McHauge/Smoke-Stopper/README.md

FOSSA Status (https://app.fossa.io/projects/git%2Bgithub.com%2FMcHauge%2FSmoke-Stopper?ref=badge_shield)

---- Smoke Stopper ----

Designed to stop the magic smoke from escaping when testing drones.

---- Development ----

Primary editor: McHauge

Current version: V8.1 has been produced and testet, now looking to fix some of the isues in V8.1 and aply that to V10

Beta Version:	
V10 - Comes with the aim to solve the problem of the mosfet used as the switch, 
failing and shorting the rails, effectively bypasing the hole system.
- Added more portection circuit
- Changed a few values of components

---- Earlier Versions ----

V9 - Layout more production friendly and in a smaller form factor.

V8.1 - Swaps some components with some of a cheaper type resulting in
about 2,5 EUR cheaper in just raw component cost, also gets a more responsive and smaller 
push button for reseting, together with a more solid on/off slider.

version V7.0 and V7.1 - With better polarity protection than V6.0, 
this meaning it will protect if the power into the input is wrong it will protect, 
but if the polarity error is after this unit then this will not protect before it trips.

version V6.0 - Tested and working, first stable version that would allow motor idling.

version V5.0 - First version to work but would not allow the drone to start up.

version V1.0-V4.0 - doesn't work as intended, does nothing, burns, or wont turn of again.

---- History ----

2018-Jul-09 - V10 In the works has a few changes in the output circuit

2017-Dec-20 - V9 Designed and made ready for production 

2017-Dec-20 - V8.1 is the 8.0 with correct solder-pads for the swapped components

2017-Dec-20 - V8 Tested with cheaper components

2017-OCT-11 - V7 has been tested with success, this version has better polarity protection.

2017-OCT-9 - All files a now up on GitHub.

2017-jan-xx - project began

## License
FOSSA Status (https://app.fossa.io/projects/git%2Bgithub.com%2FMcHauge%2FSmoke-Stopper?ref=badge_large)
