McHauge/Smoke-Stopper/V9 - Beta Production/BOM_V9.xlsx

Bill of Materials for 2-6s 3A Smoke Stopper v9.sch on 13-03-2018 10:03:37
Name | Value | Stock Number | Description | Variant ID | Variant Info
C1 | 1uF | 00L65340 | SMT CAP X7R 0603 25V E7 1UF 10%
C2 | 10uF | 97843016 | SMT CAP X7R 0805 10V E8 10uF 10%
C3 | 10uF | 00L65561 | SMT CAP X7R 1210 35V E7 10UF 10%
C18 | 100nF | 00L65196 | SMD KOND X7R 0805 50V 100nF 10%
C31 | 1nF | 98300712 | SMD CAP NP0 0603 50V 1.0NF 5%
D1 | BAS716 | 00L67043 | SMT Diode Low-leakage BAS716
D2 | GREEN | 00L60504 | SMD LYSDIODE GRON CL-170YG
D3 | RED | 00L60503 | SMD LYSDIODE ROD CL-170UR
D28 | SMCJ24A | 00L67068 | SMT DIODE SUPRESSOR SMCJ24A
J1 | Solderpad | XXXXXXXX | Solderpad 6.1 x 9.5mm, Drill 2 x 6mm
J5 | Solderpad | XXXXXXXX | Solderpad 6.1 x 9.5mm, Drill 2 x 6mm
J6 | Solderpad | XXXXXXXX | Solderpad 6.1 x 9.5mm, Drill 2 x 6mm
J7 | Solderpad | XXXXXXXX | Solderpad 6.1 x 9.5mm, Drill 2 x 6mm
Q1 | STN4NF03L | 97975784 | SMD Transistor FET N-CH 30, 6A SOT 223
Q2 | STN4NF03L | 97975784 | SMD Transistor FET N-CH 30, 6A SOT 223
Q4 | BC847B | 00L68003 | SMD TRANSISTOR NPN BC847B
Q12 | BC847B | 00L68003 | SMD TRANSISTOR NPN BC847B
R1 | 10K | 00L60293 | SMD MODST 0805 1% 100MW E5 10K0
R2 | 330R | 00L60391 | SMT RESIST 0805 5% 0.125W 150V E3 330R
R5 | 1K | 00L60823 | SMD MODST 0603 1% 63MW 50V E4 1K
R6 | 330R | 00L60391 | SMT RESIST 0805 5% 0.125W 150V E3 330R
R7 | 10K | 00L60293 | SMD MODST 0805 1% 100MW E5 10K0
R8 | 10K | 00L60293 | SMD MODST 0805 1% 100MW E5 10K0
R9 | 10K | 00L60293 | SMD MODST 0805 1% 100MW E5 10K0
R11 | 1K | 00L60349 | SMD MODST 0805 1% 100MW E4 1K0
R13 | 0R039 | 00L60622 | SMD MODST 2512 1% 2W E1 0R039
R14 | 1K | 00L60823 | SMD MODST 0603 1% 63MW 50V E4 1K
R15 | 2K4 | 00L60378 | SMD MODST 0805 1% 100MW E4 2K4
R16 | 8K2 | 00L60620 | SMD MODST 0805 1% 100MW E4 8K20
R17 | 3K | 00L60329 | SMD MODST 0805 1% 100MW E4 3K0
R38 | 10K | 00L60293 | SMD MODST 0805 1% 100MW E5 10K0
R40 | 1K | 00L60349 | SMD MODST 0805 1% 100MW E4 1K0
R46 | 10K | 00L60293 | SMD MODST 0805 1% 100MW E5 10K0
R47 | 1K | 00L60349 | SMD MODST 0805 1% 100MW E4 1K0
R65 | 15K | 00L60832 | SMD MODST 0603 1% 63MW 50V E5 15K
SW1 | 1x2 Pol | XXXXXXXX | SMD slide switch subminiature
SW2 | 1 Pol | XXXXXXXX | SMD SWITCH TACT 1 POL Normally Open
U1 | 74HC00 | 00L69029 | smd ic cmos 74hc00
U2 | LM393AD | XXXXXXXX | SMD IC LIN LM393AD DUAL COMPARATOR
U3 | 78L05 | 98489110 | SMD Volt ref 78L05 SOT89
U11 | MAX9634TEUK+ | XXXXXXXX | SMD IC Precision Current-Sense Amplifier SOT23-5
Z1 | 5.1V | 00L67300 | SMD DIODE ZENER BZX84 C 5V1 0.3W SOT23
