McHauge/Smoke-Stopper/V9 - Beta Production/Price estemate.xlsx

Sheet: Master (2)
Bill of Materials for 2-6s 3A Smoke Stopper v7.1.sch Variant Master on 11-10-2017 15:17:23
 |  |  |  | Price komp pr:
 |  |  |  | 33.987 kr.
Qty. | Ref-Des | Description | Component Type | Kr. pr.
1 | C1 | SMT CAP X7R 0603 25V E7 1UF 10% | SMD | 0.60 kr.
1 | C18 | SMD KOND X7R 0805 50V 100nF 10% | SMD | 0.10 kr.
1 | C2 | SMT CAP X7R 0805 10V E8 10uF 10% | SMD | 0.16 kr.
1 | C3 | SMT CAP X7R 1210 35V E7 10UF 10% | SMD | 2.60 kr.
1 | C31 | SMD CAP NP0 0603 50V 1.0NF 5% | SMD | 0.08 kr.
1 | D1 | SMT Diode Low-leakage BAS716 | SMD | 0.65 kr.
1 | D2 | SMD LYSDIODE GRON CL-170YG | SMD | 0.50 kr.
1 | D28 | SMT DIODE SUPRESSOR SMCJ24A | SMD | 2.70 kr.
1 | D3 | SMD LYSDIODE ROD CL-170UR | SMD | 0.40 kr.
4 | J1;J5;J6;J7 | Solderpad 6.1 x 9.5mm, Drill 2 x 6mm | Non-Assembly | 0.00 kr.
2 | Q1;Q2 | SMD Transistor FET N-CH 30, 6A SOT 223 | SMD | 1.30 kr.
2 | Q4;Q12 | SMD TRANSISTOR NPN BC847B | SMD | 0.12 kr.
6 | R1;R7;R8;R9;R38;R46 | SMD MODST 0805 1% 100MW E5 10K0 | SMD | 0.03 kr.
3 | R11;R40;R47 | SMD MODST 0805 1% 100MW E4 1K0 | SMD | 0.09 kr.
1 | R13 | SMD MODST 2512 1% 2W E1 0R039 | SMD | 3.40 kr.
1 | R15 | SMD MODST 0805 1% 100MW E4 2K4 | SMD | 0.35 kr.
1 | R16 | SMD MODST 0805 1% 100MW E4 8K20 | SMD | 0.15 kr.
1 | R17 | SMD MODST 0805 1% 100MW E4 3K0 | SMD | 0.26 kr.
2 | R2;R6 | SMT RESIST 0805 5% 0.125W 150V E3 330R | SMD | 0.20 kr.
2 | R5;R14 | SMD MODST 0603 1% 63MW 50V E4 1K | SMD | 0.02 kr.
1 | R65 | SMD MODST 0603 1% 63MW 50V E5 15K | SMD | 0.01 kr.
1 | SW1 | SMD slide switch ultraminiature | SMD | 3.00 kr.
1 | SW2 | Tact Switch 6x3.5mm Height 4.3mm White | SMD | 4.50 kr.
1 | U1 | smd ic cmos 74hc00 | SMD | 0.80 kr.
1 | U11 | SMD IC Precision Current-Sense Amplifier SOT23-5 | SMD | 10.00 kr.
1 | U2 | SMD IC OP-AMP DUAL LM393AM | SMD | 0.60 kr.
1 | U3 | SMD Volt ref 78L05 SOT89 | SMD | 0.52 kr.
1 | Z1 | SMD DIODE ZENER BZX84 C 5V1 0.3W SOT23 | SMD | 0.85 kr.

Sheet: Master
Bill of Materials for 2-6s 3A Smoke Stopper v7.1.sch Variant Master on 11-10-2017 15:17:23
Ref-Des | Value | Stock Number | Description | Component Type | Part Type | Variant ID | Variant Info | Supplier #1
C1 | 1uF | 00L65340 | SMT CAP X7R 0603 25V E7 1UF 10% | SMD | 1U/0603/25V/10%/X7R
C2 | 10uF | 97843016 | SMT CAP X7R 0805 10V E8 10uF 10% | SMD | 10U/0805/10V/10%/X7R
C3 | 10uF | 00L65561 | SMT CAP X7R 1210 35V E7 10UF 10% | SMD | 10U/1210/35V/10%/X7R
C18 | 100nF | 00L65196 | SMD KOND X7R 0805 50V 100nF 10% | SMD | 100N/0805/50V/10%/X7R
C31 | 1nF | 98300712 | SMD CAP NP0 0603 50V 1.0NF 5% | SMD | 1N/0603/50V/5%/NP0
D1 | BAS716 | 00L67043 | SMT Diode Low-leakage BAS716 | SMD | BAS716/SOD523
D2 | GREEN | 00L60504 | SMD LYSDIODE GRON CL-170YG | SMD | LED/GREEN/CL-170YG
D3 | RED | 00L60503 | SMD LYSDIODE ROD CL-170UR | SMD | LED/RED/CL-170UR
D28 | SMCJ24A | 00L67068 | SMT DIODE SUPRESSOR SMCJ24A | SMD | SMCJ24A/DO-214AB
J1 | Solderpad | XXXXXXXX | Solderpad 6.1 x 9.5mm, Drill 2 x 6mm | Non-Assembly | 1P/SOLDERPAD/6.1X9.5/2X6MM/TOP/SIDE
J5 | Solderpad | XXXXXXXX | Solderpad 6.1 x 9.5mm, Drill 2 x 6mm | Non-Assembly | 1P/SOLDERPAD/6.1X9.5/2X6MM/TOP/SIDE
J6 | Solderpad | XXXXXXXX | Solderpad 6.1 x 9.5mm, Drill 2 x 6mm | Non-Assembly | 1P/SOLDERPAD/6.1X9.5/2X6MM/TOP/SIDE
J7 | Solderpad | XXXXXXXX | Solderpad 6.1 x 9.5mm, Drill 2 x 6mm | Non-Assembly | 1P/SOLDERPAD/6.1X9.5/2X6MM/TOP/SIDE
Q1 | STN4NF03L | 97975784 | SMD Transistor FET N-CH 30, 6A SOT 223 | SMD | STN4NF03L/SOT223
Q2 | STN4NF03L | 97975784 | SMD Transistor FET N-CH 30, 6A SOT 223 | SMD | STN4NF03L/SOT223
Q4 | BC847B | 00L68003 | SMD TRANSISTOR NPN BC847B | SMD | BC847B/SOT23
Q12 | BC847B | 00L68003 | SMD TRANSISTOR NPN BC847B | SMD | BC847B/SOT23
R1 | 10K | 00L60293 | SMD MODST 0805 1% 100MW E5 10K0 | SMD | 10K/0805/1%
R2 | 330R | 00L60391 | SMT RESIST 0805 5% 0.125W 150V E3 330R | SMD | 330R/0805/5%
R4 | 0R | 00L60280 | SMD RESIST 0805 5% 0,1W 0R | SMD | 0R/0805/5%
R5 | 1K | 00L60823 | SMD MODST 0603 1% 63MW 50V E4 1K | SMD | 1K/0603/1%
R6 | 330R | 00L60391 | SMT RESIST 0805 5% 0.125W 150V E3 330R | SMD | 330R/0805/5%
R7 | 10K | 00L60293 | SMD MODST 0805 1% 100MW E5 10K0 | SMD | 10K/0805/1%
R8 | 10K | 00L60293 | SMD MODST 0805 1% 100MW E5 10K0 | SMD | 10K/0805/1%
R9 | 10K | 00L60293 | SMD MODST 0805 1% 100MW E5 10K0 | SMD | 10K/0805/1%
R11 | 1K | 00L60349 | SMD MODST 0805 1% 100MW E4 1K0 | SMD | 1K/0805/1%
R13 | 0R039 | 00L60622 | SMD MODST 2512 1% 2W E1 0R039 | SMD | 0R039/2512/2W/1%
R14 | 1K | 00L60823 | SMD MODST 0603 1% 63MW 50V E4 1K | SMD | 1K/0603/1%
R15 | 2K4 | 00L60378 | SMD MODST 0805 1% 100MW E4 2K4 | SMD | 2K4/0805/1%
R16 | 8K2 | 00L60620 | SMD MODST 0805 1% 100MW E4 8K20 | SMD | 8K2/0805/1%
R17 | 3K | 00L60329 | SMD MODST 0805 1% 100MW E4 3K0 | SMD | 3K/0805/1%
R38 | 10K | 00L60293 | SMD MODST 0805 1% 100MW E5 10K0 | SMD | 10K/0805/1%
R40 | 1K | 00L60349 | SMD MODST 0805 1% 100MW E4 1K0 | SMD | 1K/0805/1%
R46 | 10K | 00L60293 | SMD MODST 0805 1% 100MW E5 10K0 | SMD | 10K/0805/1%
R47 | 1K | 00L60349 | SMD MODST 0805 1% 100MW E4 1K0 | SMD | 1K/0805/1%
R65 | 15K | 00L60832 | SMD MODST 0603 1% 63MW 50V E5 15K | SMD | 15K/0603/1%
SW1 | PCM12SMTR | 00L50822 | SMD slide switch ultraminiature | SMD | SW/1X2P/SLIDE/C&K/PCM12SMTR
SW2 | 1p Switch 6x3.5mm | 00L50818 | Tact Switch 6x3.5mm Height 4.3mm White | Leaded | 1P_SWITCH_6X3.5MM
U1 | 74HC00 | 00L69029 | smd ic cmos 74hc00 | SMD | 74HC00/SO14
U2 | OPA2343UA | XXXXXXXX | SMD IC OP-AMP DUAL OPA2343UA | SMD | OPA2343UA/SO8
U3 | 78L05 | 98489110 | SMD Volt ref 78L05 SOT89 | SMD | 78L05/5%/SOT89
U11 | MAX9634TEUK+ | XXXXXXXX | SMD IC Precision Current-Sense Amplifier SOT23-5 | SMD | MAX9634TEUK+/SOT23-5
Z1 | 5.1V | 00L67300 | SMD DIODE ZENER BZX84 C 5V1 0.3W SOT23 | SMD | 5.1V/5%/BZX84-C5V1/SOT23
