McHauge/Smoke-Stopper/V9 - Beta Production/SCH_2-6s_3A_Smoke_Stopper v9.pdf

# 3.4A Smoke Stopper! V9

# Current sense

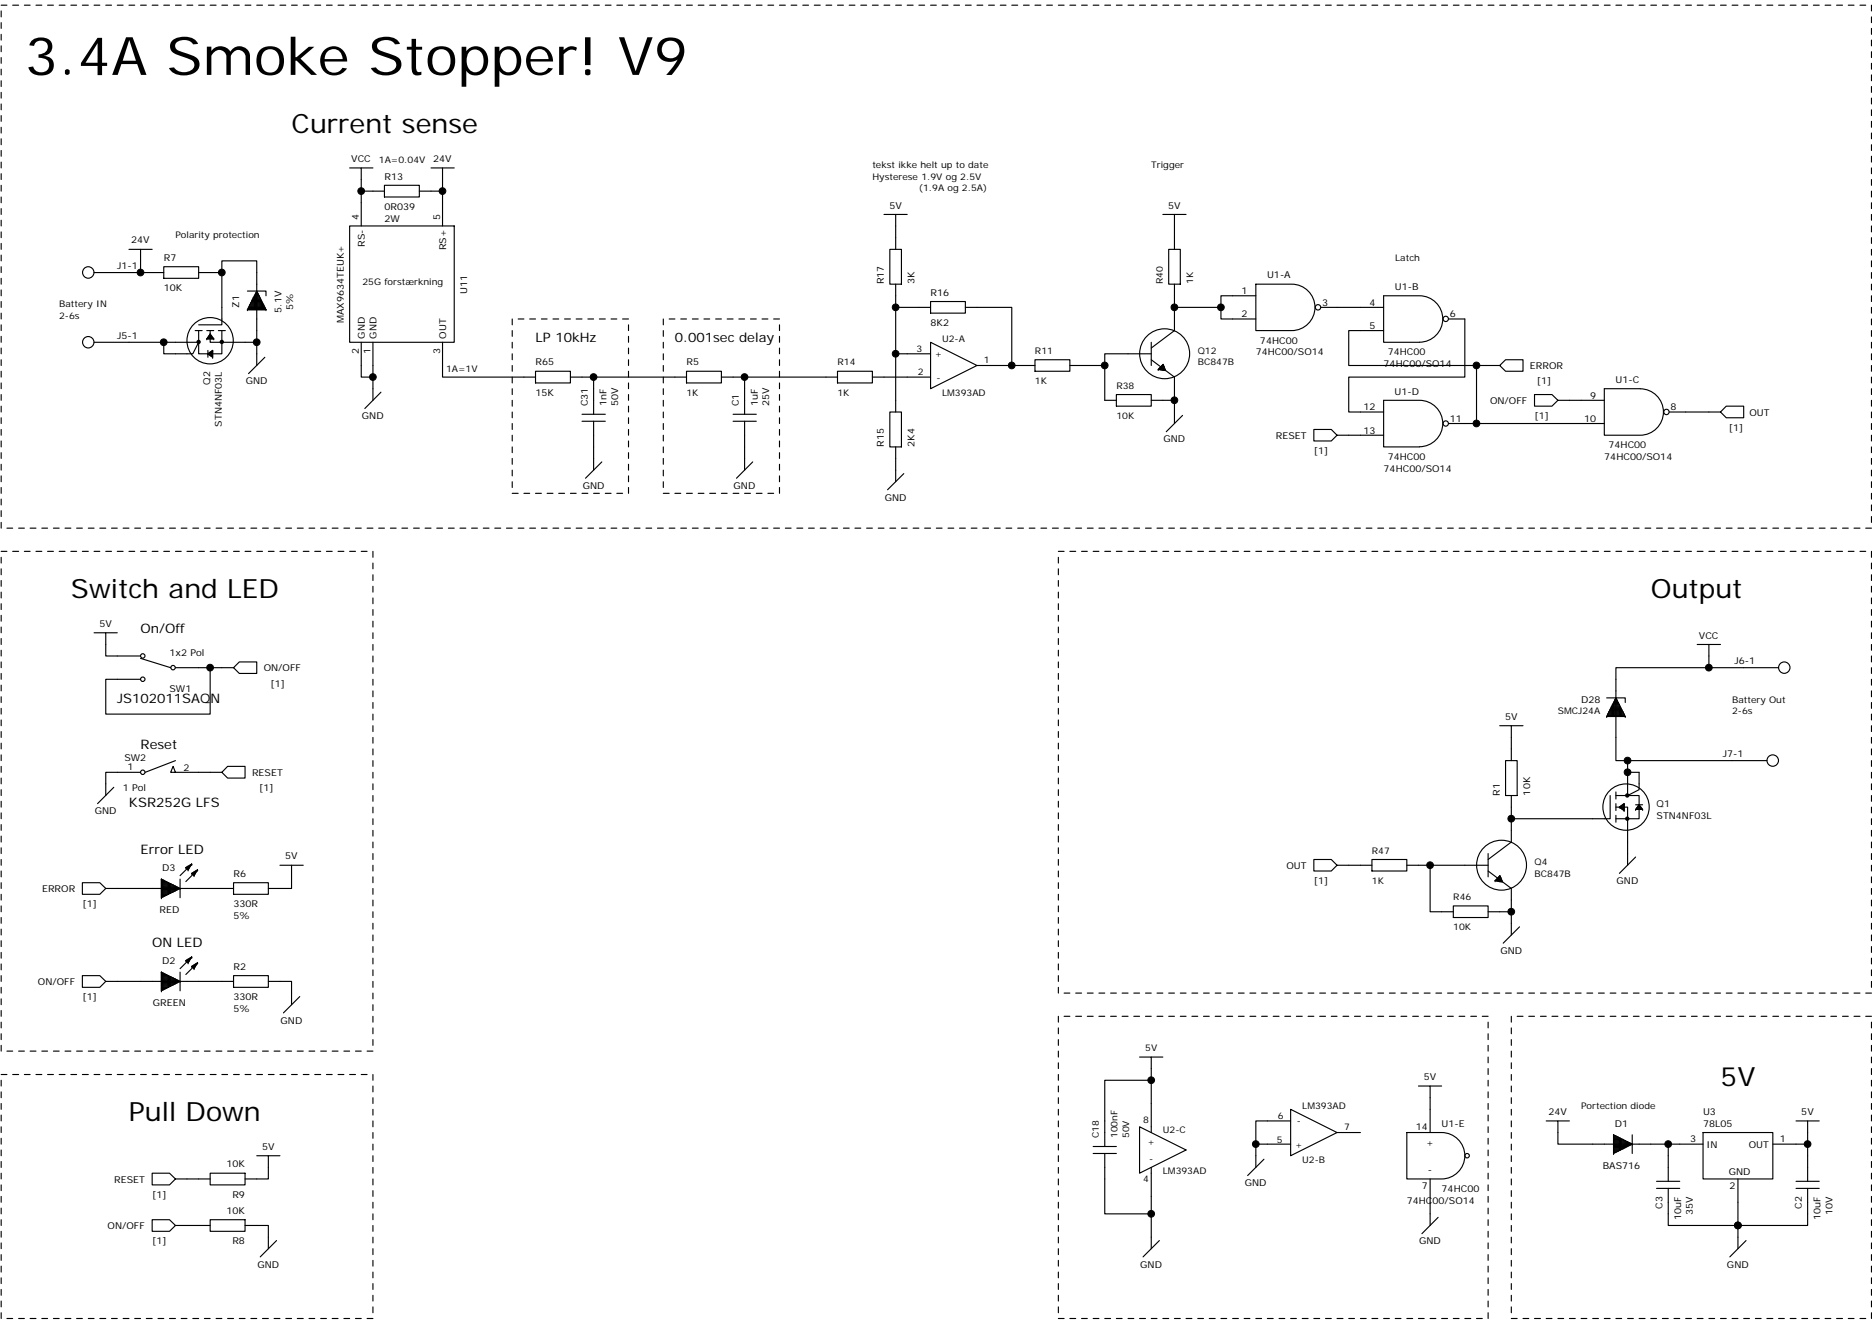
[picture p1: page 1]

tekst ikke helt up to date
Hysterese 1.9V og 2.5V
