McHauge/Smoke-Stopper/V9 - Beta Production/PCB_2-6s_3A_Smoke_Stopper v9.pdf

# J1J1x1

# J6J6x1

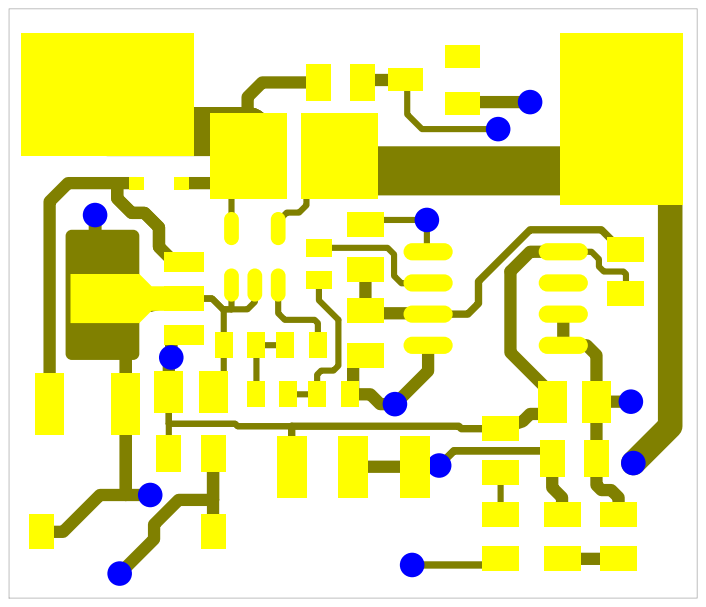
[picture p2: page 1]
R13R¹³x2 R¹³x1 U3U³x2 U³x1 U³x3; C3C2C²x1 C²x2 C³x1; C³x2; R9R⁹x1 R⁹x2; R8R⁸x2 R⁸x1 R2R²x1 R²x2; R15R¹⁵x1 R¹⁵x2; R6R⁶x1 R⁶x2; R17R¹⁷x1 R¹⁷x2; R16R¹⁶x1 R¹⁶x2; U11 U¹¹x1 U¹¹x2 U¹¹x3 U¹¹x5; U¹¹x4; C18C¹⁸x2 C¹⁸x1; R5R⁵x1 R⁵x2; C31C³¹x1 C³¹x2 R65R⁶⁵x2 R⁶⁵x1 C1C¹x2 C¹x1; R14R¹⁴x1 R¹⁴x2; R7R⁷x1 R⁷x2 Z1Z1x1 Z1x2 Z1x3; D1D¹x2; D¹x1; D2D²x1; D3D³x1; U2U²x1 U²x2 U²x3 U²x4; U²x5 U²x6 U²x7 U²x8; SW2 SW²x1; SW²x2 SW1 SW¹x1; SW¹x2; SW¹x3

# J5J5x1

# J7J7x1

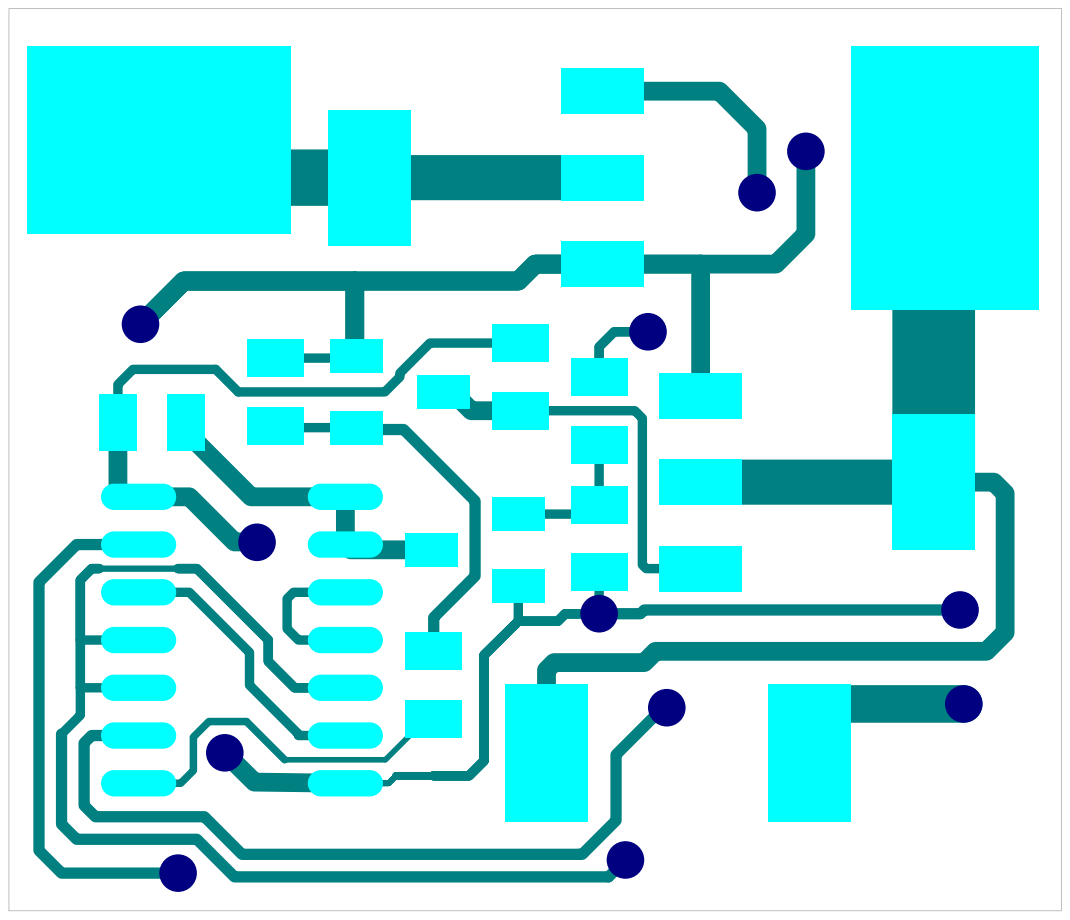
[picture p3: page 2]
Q4Q⁴x1 Q⁴x2; Q⁴x3; D28 D²⁸x1; D²⁸x2; R47R⁴⁷x1 R⁴⁷x2; R46R⁴⁶x1 R⁴⁶x2; U1U¹x1 U¹x2 U¹x3 U¹x4 U¹x5 U¹x6 U¹x8; U¹x7 U¹x9 U¹x10 U¹x11 U¹x12 U¹x13 U¹x14; R11R¹¹x1 R¹¹x2 R38R³⁸x1 R³⁸x2; R40R⁴⁰x2; R⁴⁰x1; Q12Q¹²x1 Q¹²x2Q¹²x3; Q1Q¹x1 Q¹x2 Q¹x3; Q¹x4; R1R¹x1; Q2R¹x2 Q²x1 Q²x2 Q²x3Q²x4

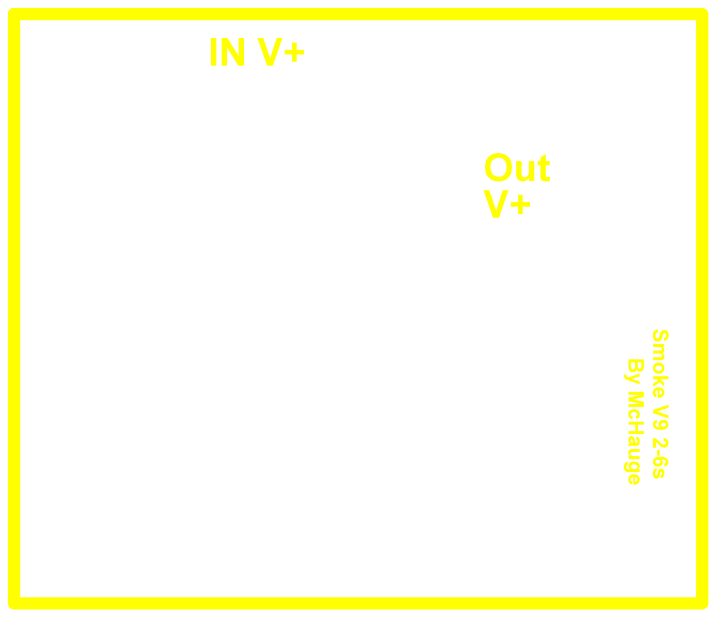
[picture p4: page 3]
Out V+; Smoke V9 2-6s; By McHauge

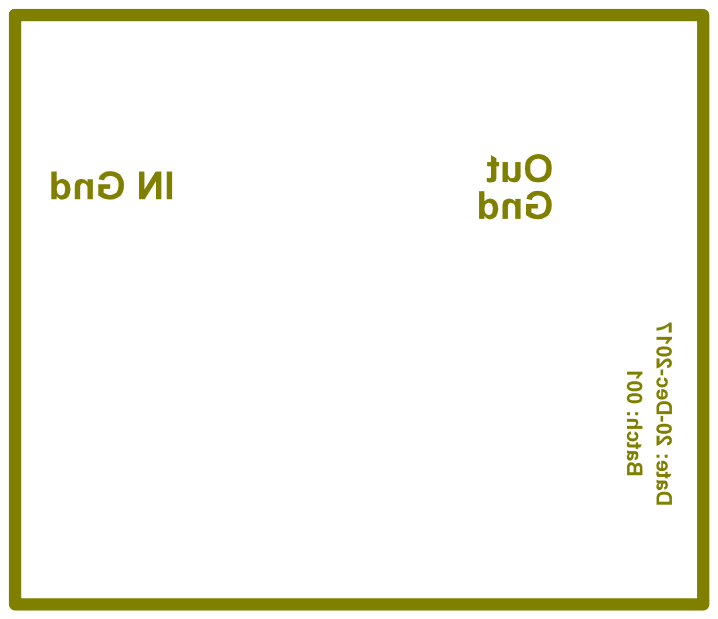
[picture p5: page 4]
Batch: 001; Date: 20-Dec-2017

# J1J1x1

# J6J6x1

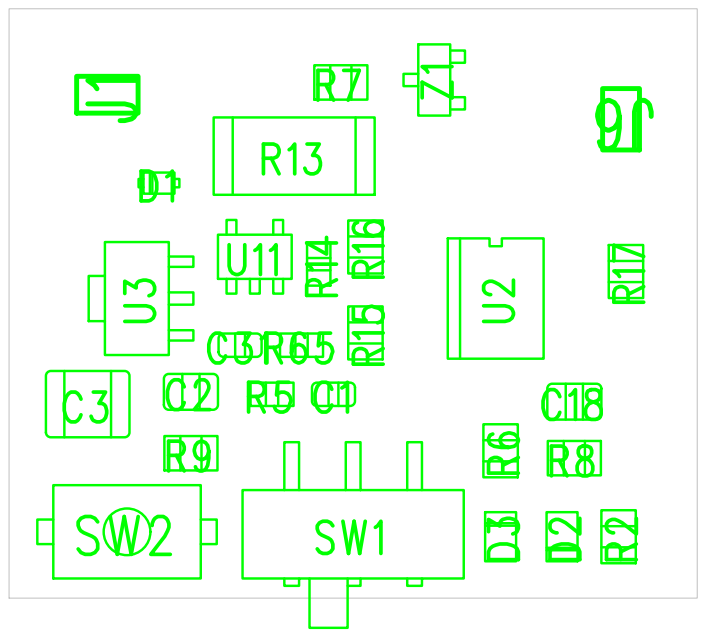
[picture p6: page 5]

# J5J5x1

# J7J7x1

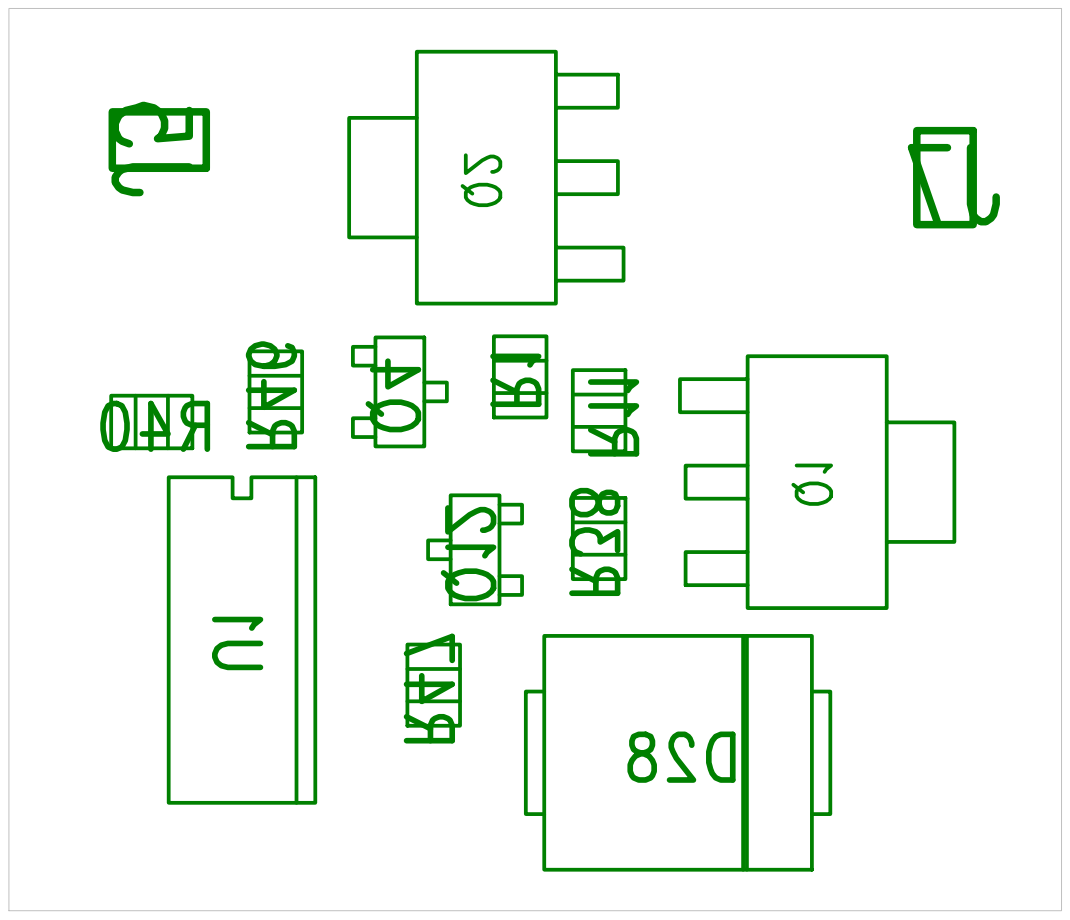
[picture p7: page 6]

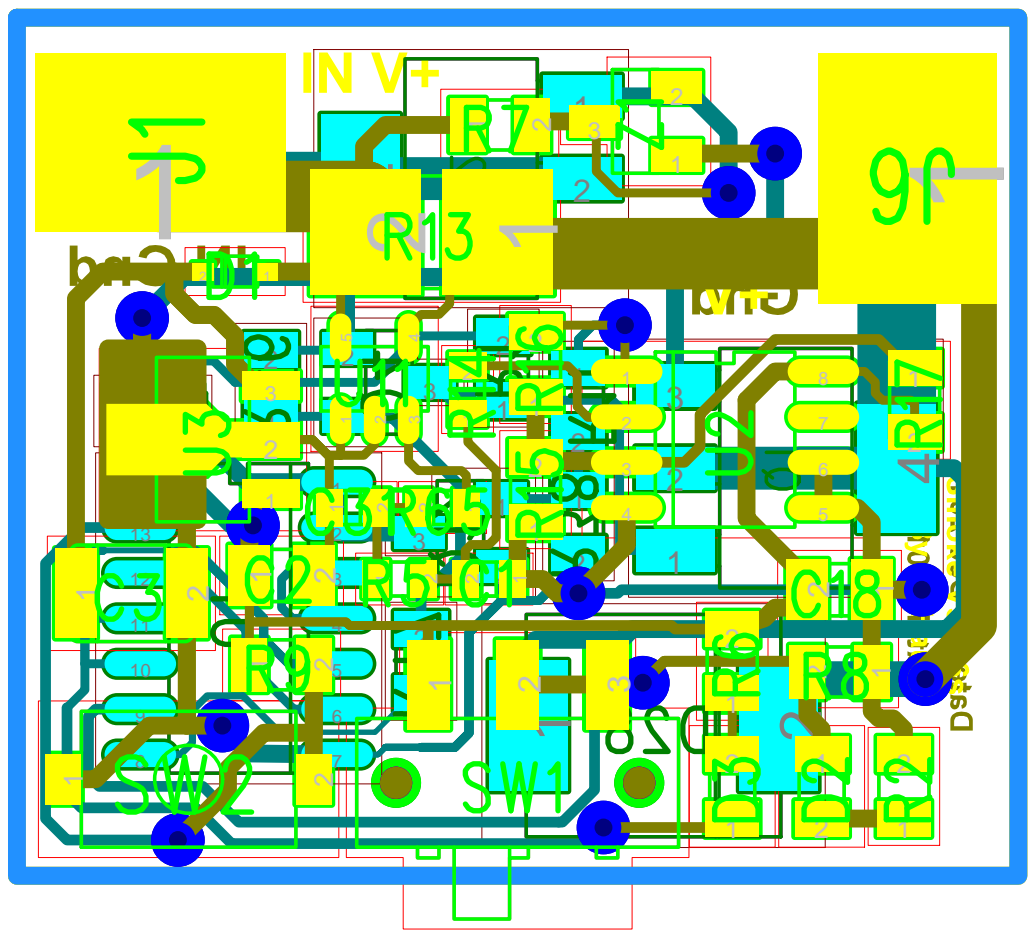
[picture p8: page 7]

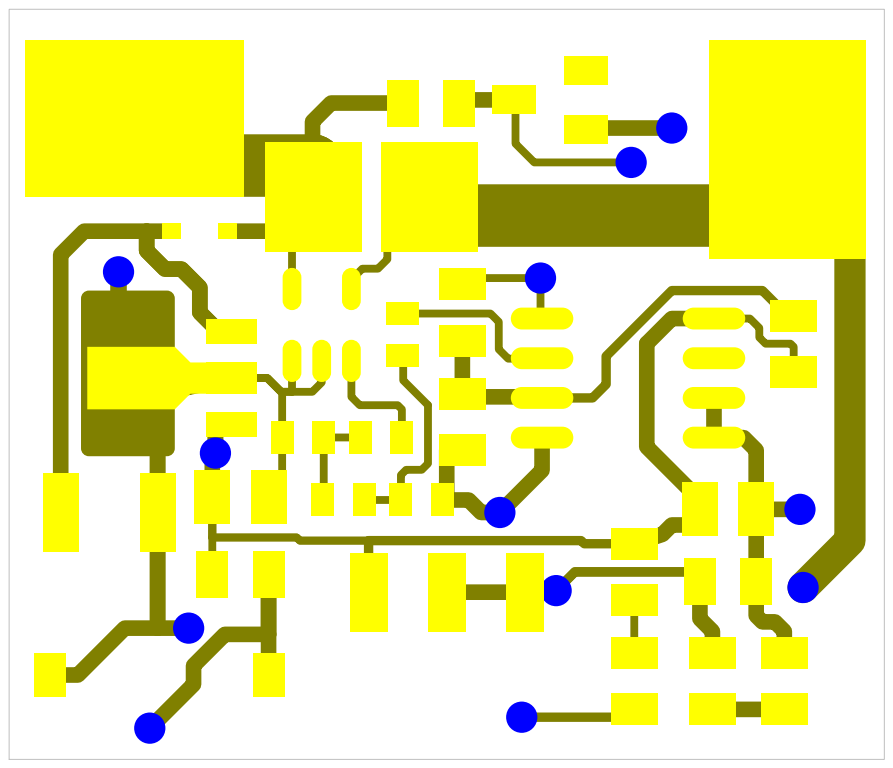
[picture p9: page 8]
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

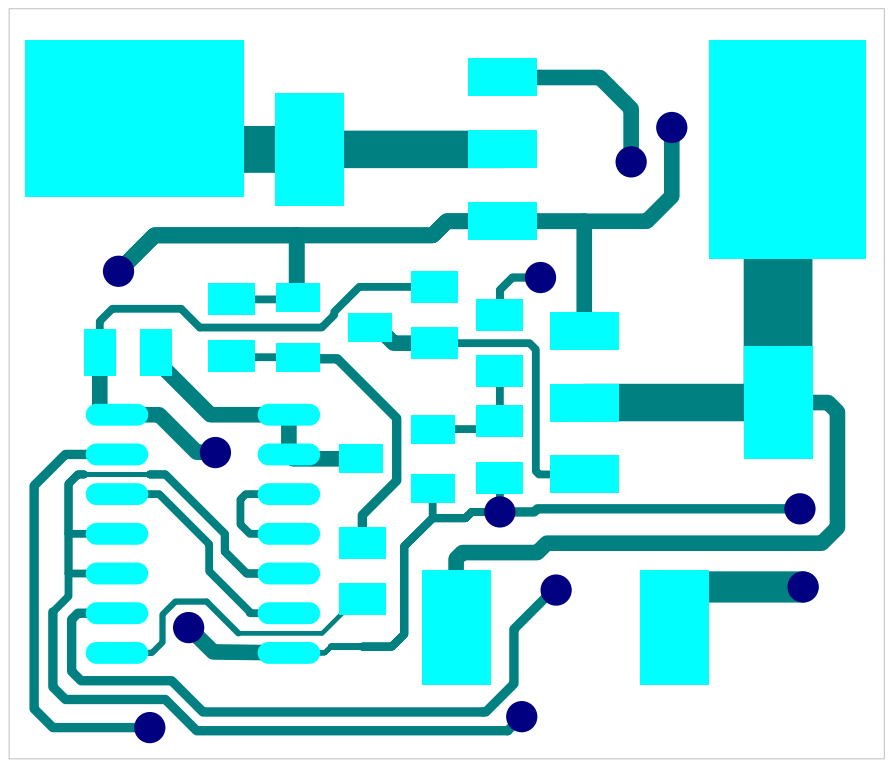
[picture p10: page 9]
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
