McHauge/Smoke-Stopper/V7.1/2-6s 2A Smoke Stopper v7.1 sch.pdf

# 3.4A Smoke Stopper! V7.1

# Current sense

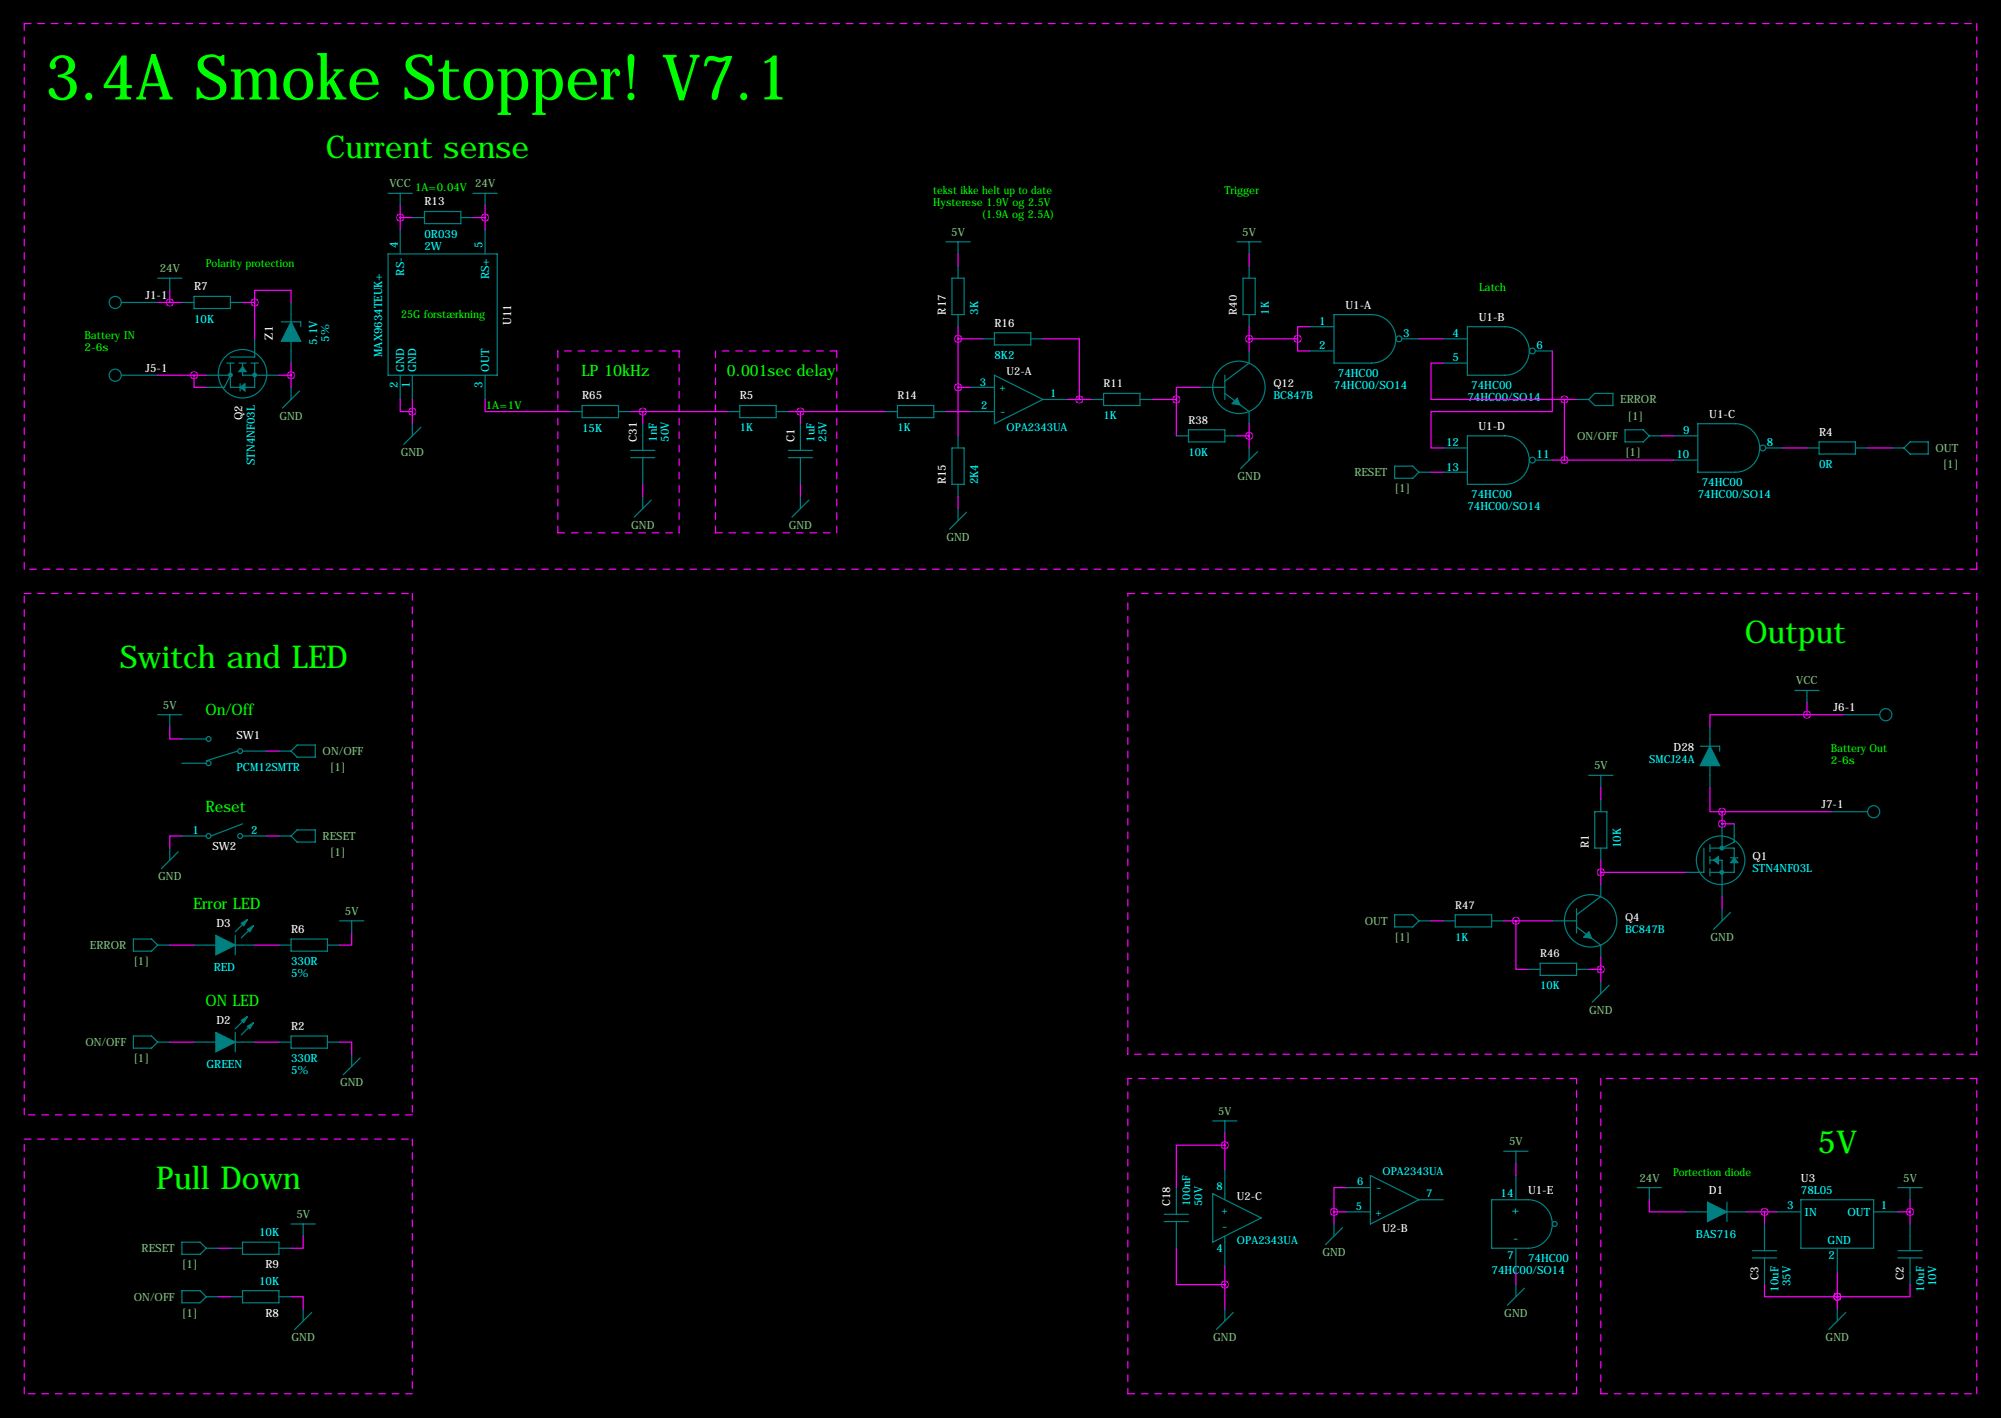
[picture p11: page 1]

tekst ikke helt up to date
Hysterese 1.9V og 2.5V
