McHauge/Smoke-Stopper/V7.1/2-6s 2A Smoke Stopper v7.1 pcb.pdf

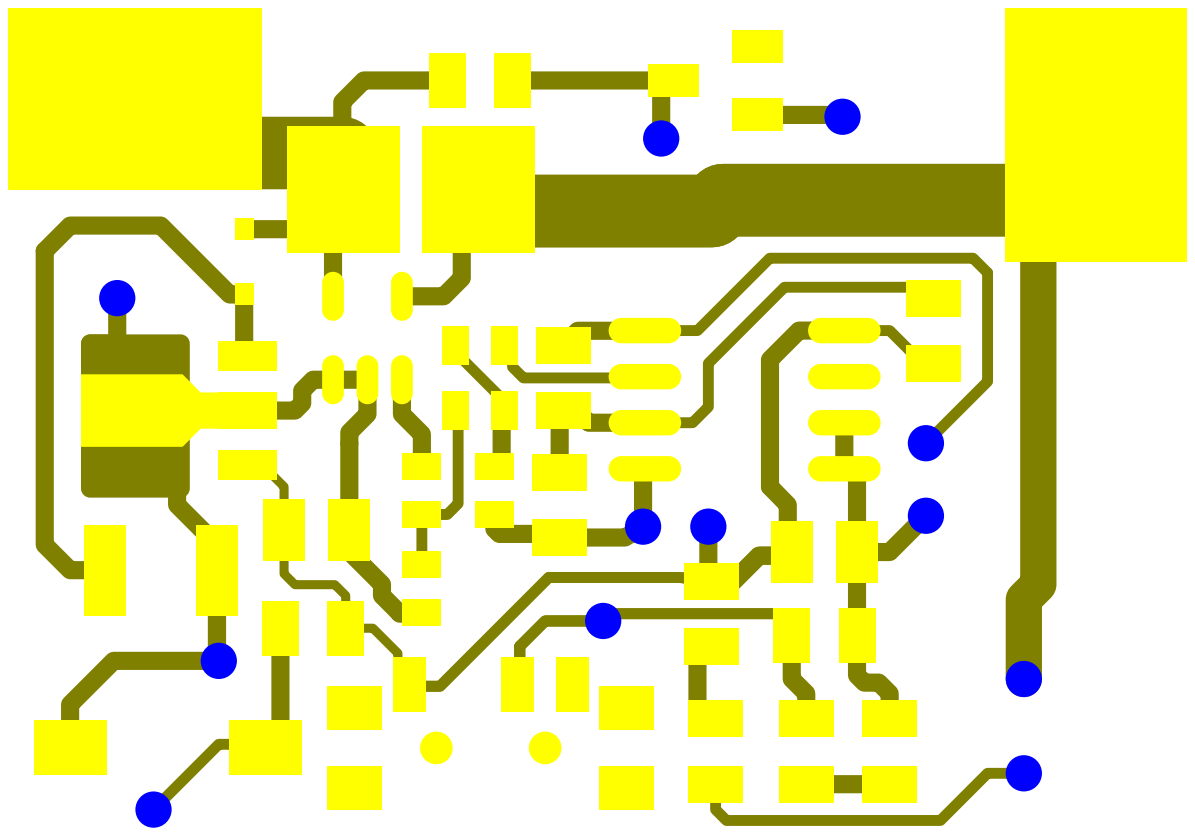
[picture p19: page 1]
R13R¹³x2 R¹³x1 U3U³x2 U³x1 U³x3; SW1 SW¹x1; SW¹x2 SW¹x3 SW¹xMTH¹; SW¹xMTH² SW¹xMTP¹ SW¹xMTP²; SW¹xMTP³ SW¹xMTP⁴; C2C²x1 C²x2; C3C³x1; C³x2; SW2 SW²x1; SW²x2; R9R⁹x2 R⁹x1; R8R⁸x2 R⁸x1 R2R²x1 R²x2; U2U²x1 U²x2 U²x3 U²x4; U²x5 U²x6 U²x7 U²x8; R15R¹⁵x1 R¹⁵x2; R6R⁶x1 R⁶x2; R17R¹⁷x1 R¹⁷x2; R16R¹⁶x1; C18C¹⁸x2 C¹⁸x1; R5R⁵x1 R⁵x2 R65R⁶⁵x1 R⁶⁵x2 C31C³¹x1 C³¹x2; C1C¹x1 C¹x2; R14R¹⁴x1 R¹⁴x2; R7R⁷x1 R⁷x2; D1D¹x1 D¹x2; D2D²x1; D3D³x1

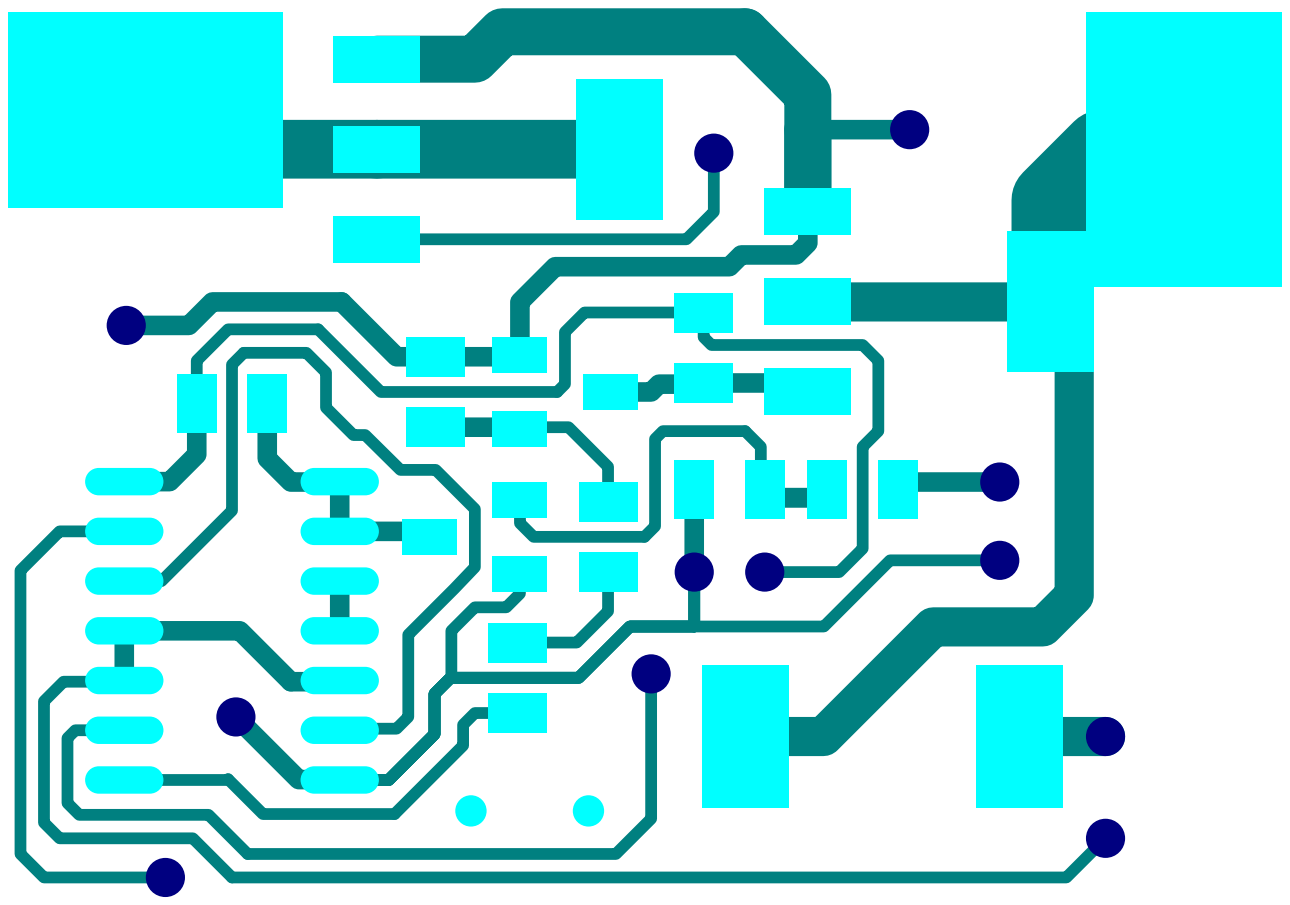
[picture p20: page 2]
Q4Q⁴x1 Q⁴x2; Q⁴x3; D28 D²⁸x1; D²⁸x2; SW1 SW¹xMTH¹; SW¹xMTH²; R47R⁴⁷x1 R⁴⁷x2; R46R⁴⁶x1 R⁴⁶x2; U1U¹x1 U¹x2 U¹x3 U¹x4 U¹x5 U¹x6 U¹x8; U¹x7 U¹x9 U¹x10 U¹x11 U¹x12 U¹x13 U¹x14; R38R³⁸x2; R³⁸x1 R11R¹¹x2; R¹¹x1; R40R⁴⁰x2; R⁴⁰x1; Q12Q¹²x1 Q¹²x2Q¹²x3 R4R⁴x1 R⁴x2; Q1Q¹x1 Q¹x2 Q¹x3

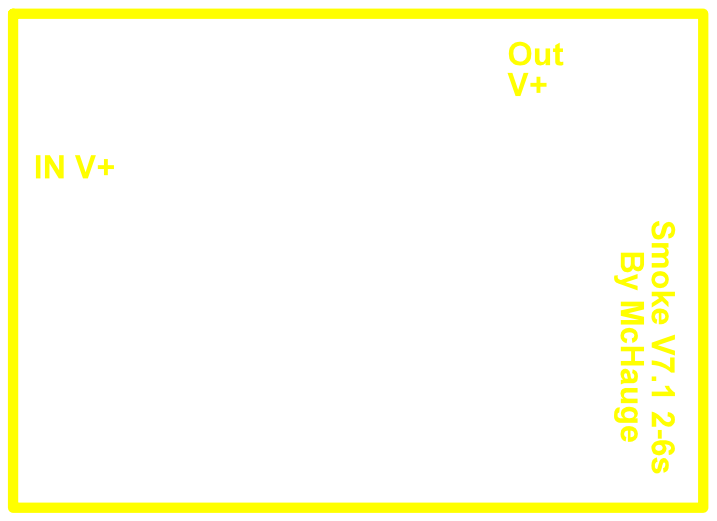
[picture p21: page 3]
Out V+; Smoke V7.1 2-6s; By McHauge

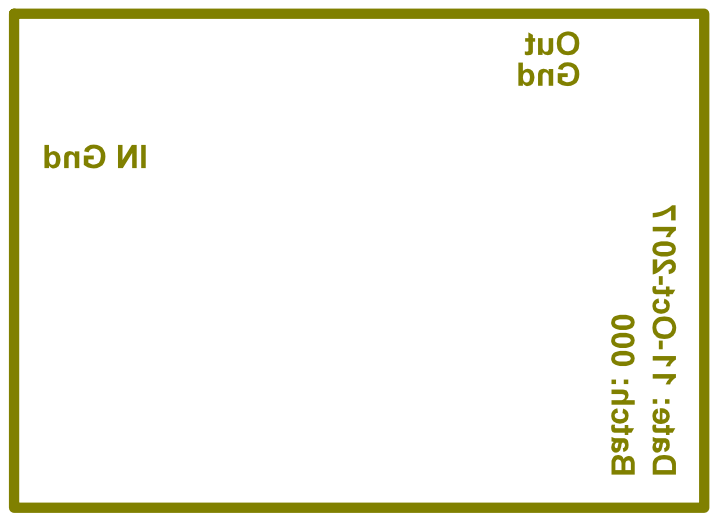
[picture p22: page 4]
Batch: 000; Date: 11-Oct-2017

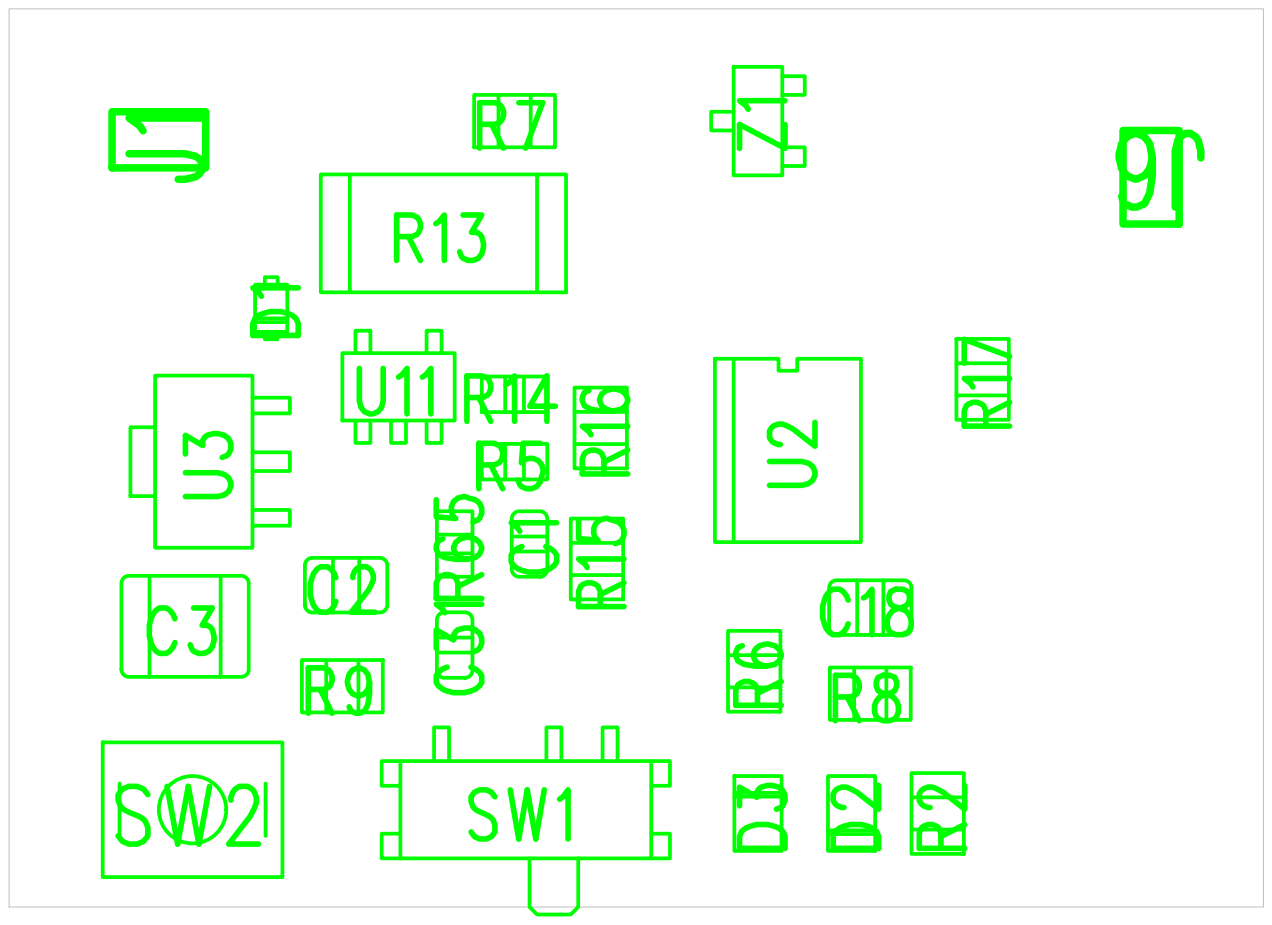
[picture p23: page 5]

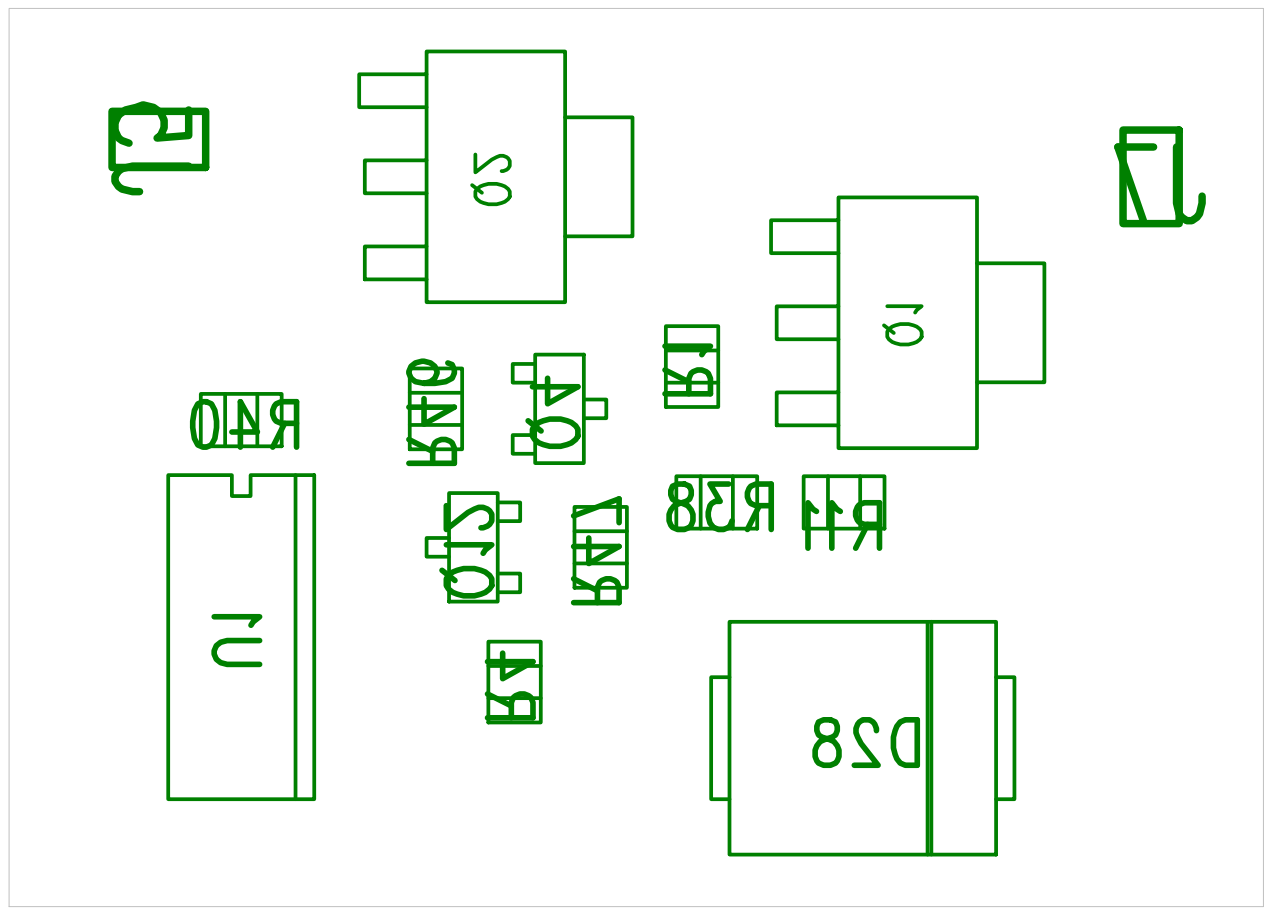
[picture p24: page 6]

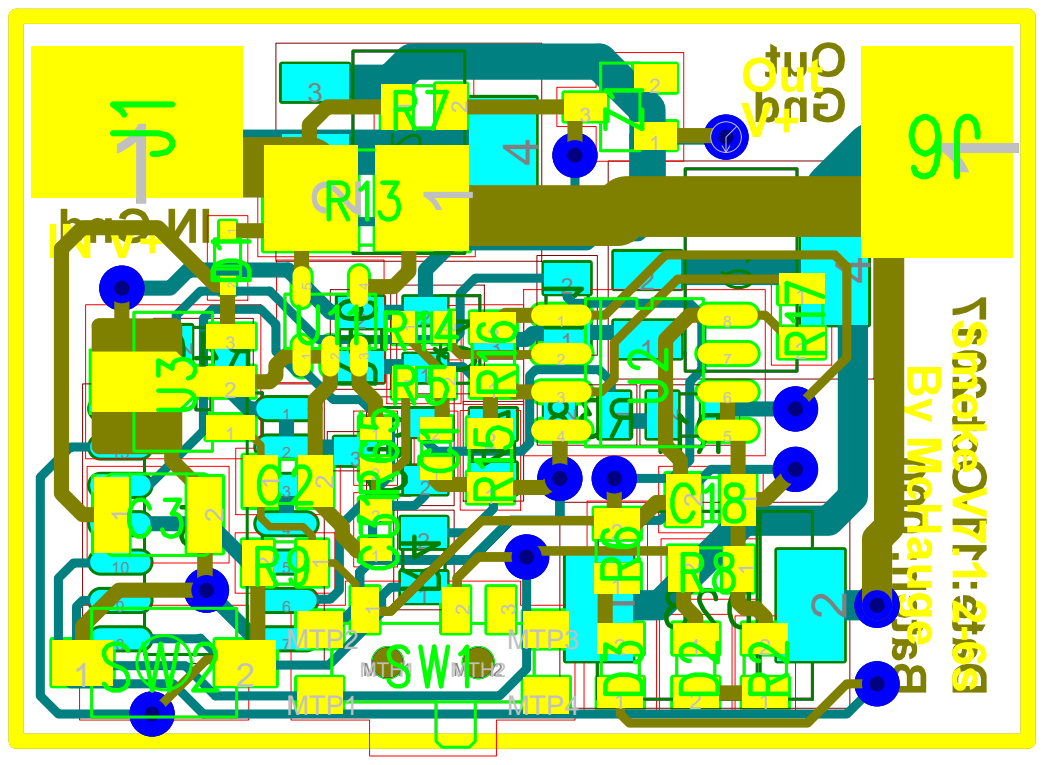
[picture p25: page 7]
