McHauge/Smoke-Stopper/(list of files, drawings)

Other design files:
Lite Edition/V1_Lite/2-6s 2A Smoke Stopper v6.pcb
V1.0/2-6s 2A Smoke Stopper.pcb
V2.0/2-6s 2A Smoke Stopper v2.pcb
V3.0/2-6s 2A Smoke Stopper v3.pcb
V4.0/2-6s 2A Smoke Stopper v4.pcb
V5.0/2-6s 2A Smoke Stopper v5.pcb
V6.0/2-6s 3A Smoke Stopper v6.pcb
V7.0/2-6s 3A Smoke Stopper v7.pcb
V8.0 - Skip this version/2-6s 3A Smoke Stopper v8.pcb
V8.1/2-6s 3A Smoke Stopper v8.1.pcb
V9 - Beta Production/2-6s 3A Smoke Stopper v9.pcb
V10/2-6s 3A Smoke Stopper v10.pcb
V10/simulation/SMOKE_STOPPER_V10.DSN
V10/simulation/Smoke_Stopper_V10.opj
