McHauge/Smoke-Stopper/(commit log)

2017-10-09 Import of project files
    [2-6s 2A Smoke Stopper v2.pcb, 2-6s 2A Smoke Stopper v2.sch, 2-6s 2A Smoke Stopper v3.pcb, 2-6s 2A Smoke Stopper v3.sch, 2-6s 2A Smoke Stopper v4.pcb, 2-6s 2A Smoke Stopper v4.sch, 2-6s 2A Smoke Stopper v5.pcb, 2-6s 2A Smoke Stopper v5.sch]
2017-10-10 V7.0 Beta ready for testing
    [2-6s 3A Smoke Stopper v7.pcb, 2-6s 3A Smoke Stopper v7.sch]
2017-10-11 V7 is out
    V7 is now becomes the current version, with better polaity portection.
    [2-6s 3A Smoke Stopper v7.pcb, 2-6s 3A Smoke Stopper v7.sch]
2017-10-11 V7.1 prepaired for smal priduction runs
    Made minor changes to v7.0 for better and cheaper production runs this is stored under V7.1, to gether with an estimate price per unit without pcb manufacturing or assemply
    [2-6s 3A Smoke Stopper v7.1.pcb, 2-6s 3A Smoke Stopper v7.1.sch, 2-6s 3A Smoke Stopper v7.pcb, 2-6s 3A Smoke Stopper v7.sch, Price estemate.xlsx]
2017-10-12 Preparing for V8.0 with some inprovments in terms of price pr unit
    [2-6s 3A Smoke Stopper v7.1.sch, 2-6s 3A Smoke Stopper v8.pcb, 2-6s 3A Smoke Stopper v8.sch, Price estemate.xlsx]
2017-10-13 V8.0 beta, going for an optimized BOM
    V8.0 beta, going for an optimized BOM resulting in 2,5 EUR cheaper in raw component cost.
    [2-6s 3A Smoke Stopper v8.pcb, 2-6s 3A Smoke Stopper v8.sch, Price estemate.xlsx]
2017-12-20 Component Layout updated
    Component Layout updated to fit the new and cheaper components
    [2-6s 3A Smoke Stopper v8.1.pcb, 2-6s 3A Smoke Stopper v8.1.sch, 2-6s 3A Smoke Stopper v8.pcb, 2-6s 3A Smoke Stopper v8.sch, Price estemate.xlsx]
2017-12-20 V9 - Smaller and more production friendly
    V9 - Smaller and more production friendly
    [2-6s 3A Smoke Stopper v8.1.pcb, 2-6s 3A Smoke Stopper v8.1.sch, 2-6s 3A Smoke Stopper v9.pcb, 2-6s 3A Smoke Stopper v9.sch, Price estemate.xlsx]
2018-02-21 V9 - PDF Files
    Added PDF files for version 9
    [2-6s 3A Smoke Stopper v9.pcb, 2-6s 3A Smoke Stopper v9.sch, Price estemate.xlsx]
2018-03-13 Minor updates
    Added BOM for v9
    [2-6s 3A Smoke Stopper v9.pcb, BOM_V9.xlsx]
2018-07-09 Added V10
    V10 Comes with the aim to solve the problem of the mosfet used as the switch, failing and shorting the rails, effectively bypasing the hole system
    - Added more portection circuit
    - Changed a few values of components
    [2-6s 3A Smoke Stopper v10.pcb, 2-6s 3A Smoke Stopper v10.sch, 2-6s 3A Smoke Stopper v9.pcb, SMOKE_STOPPER_V10.DSN, Smoke_Stopper_V10.opj]
2018-07-24 sdfsdf
    sdfsdf
    [2-6s 2A Smoke Stopper v6.sch, 2-6s 3A Smoke Stopper v10.sch]
